san16132/Actuadores-Lineales/README.md

# Actuadores-Lineales

Diseños y código de actuadores lineales de faja, tornillo y cremallera.
