san16132/Actuadores-Lineales/Inventor Actuadores/BOM/BOM Cremallera.xlsx

Item | Nombre | Thumbnail | Precio | QTY | Total | Descripción | REV
1 | Acople eje motor |  | Q 10.00 | 1 | Q 10.00 | Impresión 3D | IR
2 | Engrane |  | Q 5.00 | 1 | Q 5.00 | Corte Láser | IR
3 | Cremallera |  | Q 5.00 | 1 | Q 5.00 | Corte Láser | IR
4 | Riel cremallera p1 |  | Q 5.00 | 1 | Q 5.00 | Corte Láser | IR
5 | Riel cremallera p2 |  | Q 5.00 | 1 | Q 5.00 | Corte Láser | IR
6 | Nema_17-17HS4401 |  | Q 100.00 | 1 | Q 80.00 | https://www.amazon.com/Usongshine-Stepper-17HS4401S-Connector-Printer/dp/B0787BQ4WH | IR
7 | Tope riel motor |  | Q 5.00 | 1 | Q 5.00 | Corte Láser | IR
8 | Riel acople de motor |  | Q 15.00 | 1 | Q 15.00 | Impresión 3D | IR
9 | M3.5 |  | Q 9.00 | 4 | Q 36.00 | La Casa del Tornillo | IR
10 | M3 |  | Q 8.00 | 1 | Q 8.00 | La Casa del Tornillo | IR
11 | Push Button |  | Q 1.00 | 2 | Q 2.00 | Electrónica ABC | IR
