san16132/Actuadores-Lineales/Inventor Actuadores/BOM/BOM Faja.xlsx

Item | Nombre | Imagen | Precio | QTY | Total | Descripción | REV
1 | Nema_17-17HS4401 |  | Q 100.00 | 1 | Q 100.00 | https://www.amazon.com/Usongshine-Stepper-17HS4401S-Connector-Printer/dp/B0787BQ4WH | IR
2 | Acople eje motor |  | Q 10.00 | 1 | Q 10.00 | Impresión 3D | IR
3 | Faja motor |  | Q 10.00 | 2 | Q 20.00 | Impresión 3D | IR
4 | Riel |  | Q 8.00 | 2 | Q 16.00 | Librería Progreso | IR
5 | Salida |  | Q 10.00 | 1 | Q 10.00 | Impresión 3D | IR
6 | Tope riel final |  | Q 5.00 | 2 | Q 10.00 | Corte Láser | IR
7 | Tope riel motor 2 |  | Q 5.00 | 1 | Q 5.00 | Corte Láser | IR
8 | Anillo riel |  | Q 5.00 | 2 | Q 10.00 | Corte Láser | IR
9 | Tope riel motor |  | Q 5.00 | 1 | Q 5.00 | Corte Láser | IR
10 | Eje |  | Q 8.00 | 1 | Q 8.00 | Librería Progreso | IR
11 | Eje 2 |  | Q 2.00 | 1 | Q 2.00 | Librería Progreso | IR
12 | M3.5 |  | Q 9.00 | 4 | Q 36.00 | La Casa del Tornillo | IR
13 | M3 |  | Q 7.00 | 1 | Q 7.00 | La Casa del Tornillo | IR
14 | faja |  | Q 10.00 | 1 | Q 10.00 | - | IR
15 | Pin |  | Q 2.00 | 2 | Q 4.00 | Librería Progreso | IR
16 | Push Button |  | Q 1.00 | 2 | Q 2.00 | Electrónica ABC | IR
