san16132/Actuadores-Lineales/Inventor Actuadores/BOM/BOM Tornillo.xlsx

Item | Nombre | Imagen | Precio | QTY | Total | Descripción | REV
1 | Nema_17-17HS4401 |  | Q 100.00 | 1 | Q 100.00 | https://www.amazon.com/Usongshine-Stepper-17HS4401S-Connector-Printer/dp/B0787BQ4WH | IR
2 | Acople eje motor |  | Q 10.00 | 1 | Q 10.00 | Impresión 3D | IR
3 | Acople tornillo M8 |  | Q 10.00 | 1 | Q 10.00 | Impresión 3D | IR
4 | Tope riel motor |  | Q 5.00 | 1 | Q 5.00 | Corte Láser | IR
5 | Tope riel final |  | Q 5.00 | 1 | Q 5.00 | Corte Láser | IR
6 | Riel |  | Q 8.00 | 2 | Q 16.00 | Librería Progreso | IR
7 | Anillo riel |  | Q 5.00 | 2 | Q 10.00 | Corte Láser | IR
8 | Acople tuerca salida |  | Q 10.00 | 1 | Q 10.00 | Impresión 3D | IR
9 | Base |  | Q 5.00 | 1 | Q 5.00 | Corte Láser | IR
10 | M3.5 |  | Q 9.00 | 4 | Q 36.00 | La Casa del Tornillo | IR
11 | M3 |  | Q 7.00 | 1 | Q 7.00 | La Casa del Tormillo | IR
12 | Tornillo |  | Q 10.00 | 1 | Q 10.00 | Cemaco | IR
13 | Tuerca |  | Q 1.00 | 1 | Q 1.00 | Cemaco | IR
14 | Push Button |  | Q 1.00 | 2 | Q 2.00 | Electrónica ABC | IR
