san16132/Actuadores-Lineales/Inventor Actuadores/Actuador Cremallera/Fabricación/Riel acople de motor.stl

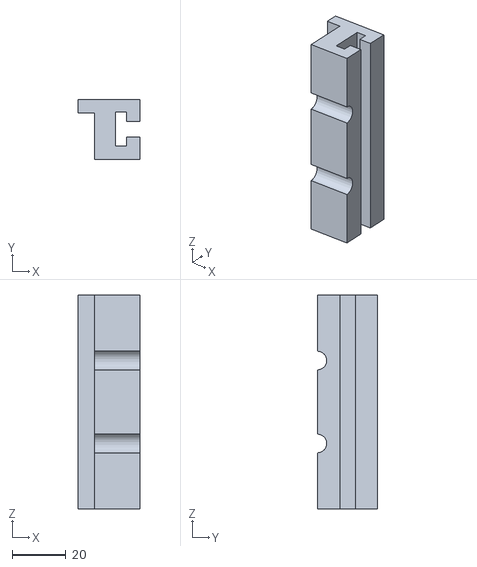
[picture p3: CAD file, 2020-03-03]
Inventor Actuadores/Actuador Cremallera/Fabricación/Riel acople de motor.stl
23.0 x 22.5 x 80.0
