san16132/Actuadores-Lineales/Inventor Actuadores/Actuador Faja/Fabricación/Faja motor largo.stl

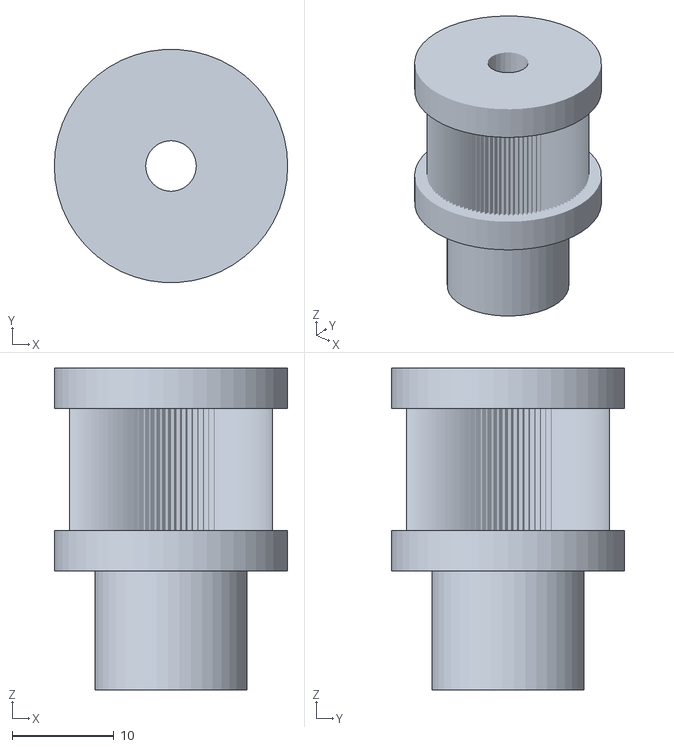
[picture p4: CAD file, 2020-03-03]
Inventor Actuadores/Actuador Faja/Fabricación/Faja motor largo.stl
23.0 x 23.0 x 31.7
