san16132/Actuadores-Lineales/Inventor Actuadores/Actuador Tornillo/Fabricación/Acople tuerca salida.stl

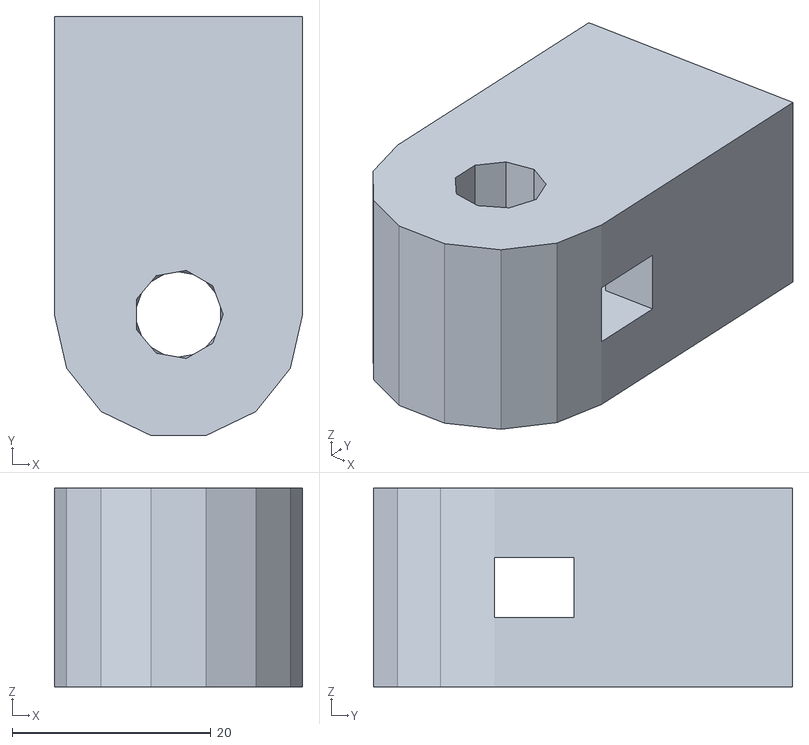
[picture p5: CAD file, 2020-03-03]
Inventor Actuadores/Actuador Tornillo/Fabricación/Acople tuerca salida.stl
25.0 x 42.2 x 20.0
