san16132/Actuadores-Lineales/Inventor Actuadores/Actuador Tornillo/Nema 17/Nema_17-17HS4401.step

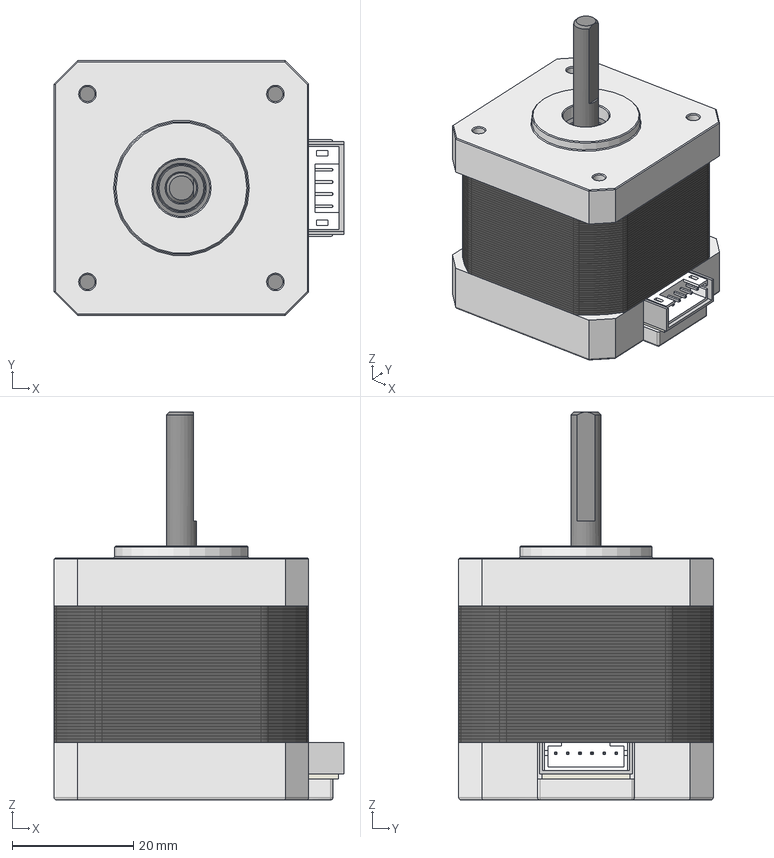
[picture p6: CAD file, 2020-03-03]
Inventor Actuadores/Actuador Tornillo/Nema 17/Nema_17-17HS4401.step
47.8 x 42.0 x 64.0 mm
M3x30-Screw_001
M3x30-Screw_002
M3x30-Screw_003
M3x30-Screw_004
