san16132/Actuadores-Lineales/Inventor Actuadores/Fabricación/Actualizados/Impresión 3D/Faja motor largo.stl

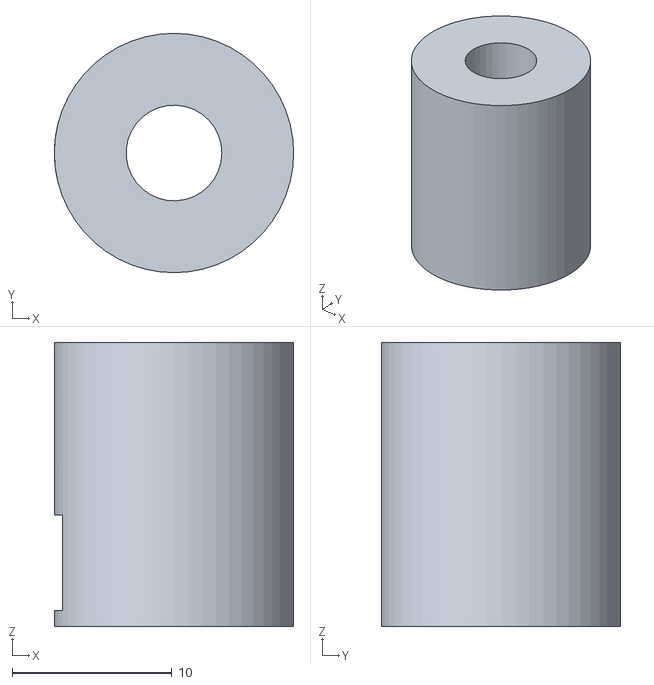
[picture p7: CAD file, 2020-03-03]
Inventor Actuadores/Fabricación/Actualizados/Impresión 3D/Faja motor largo.stl
15.0 x 15.0 x 17.8
