san16132/Actuadores-Lineales/Inventor Actuadores/Actuador Faja/Fabricación/Acople eje motor.stl

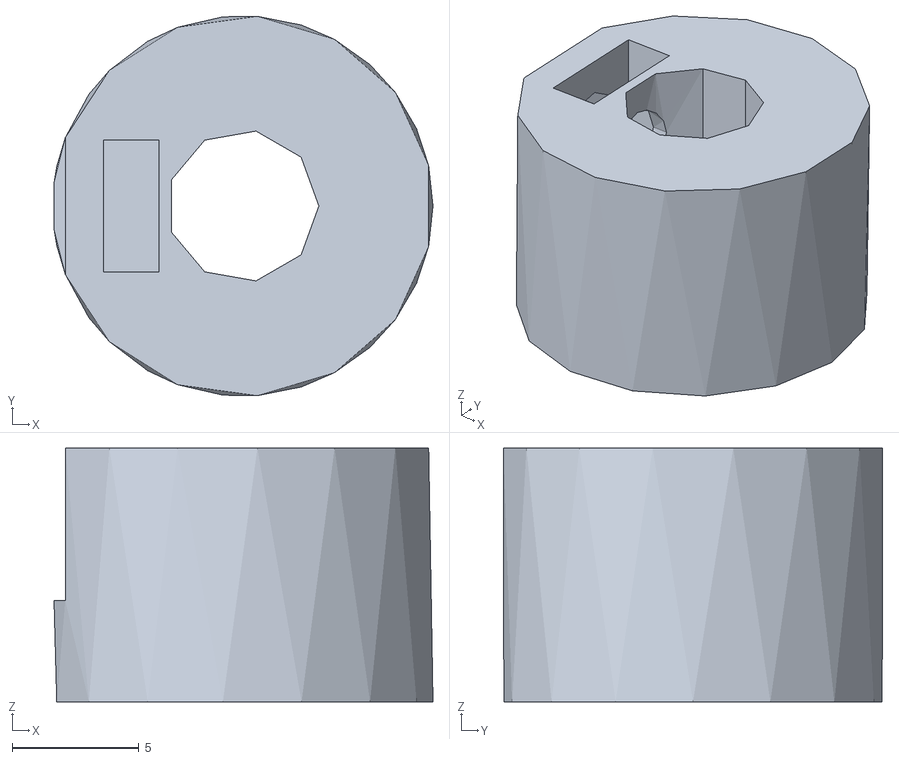
[picture p8: CAD file, 2020-03-03]
Inventor Actuadores/Actuador Faja/Fabricación/Acople eje motor.stl
14.9 x 15.0 x 10.0
