san16132/Actuadores-Lineales/Inventor Actuadores/Actuador Tornillo/Fabricación/Acople tornillo M8.stl

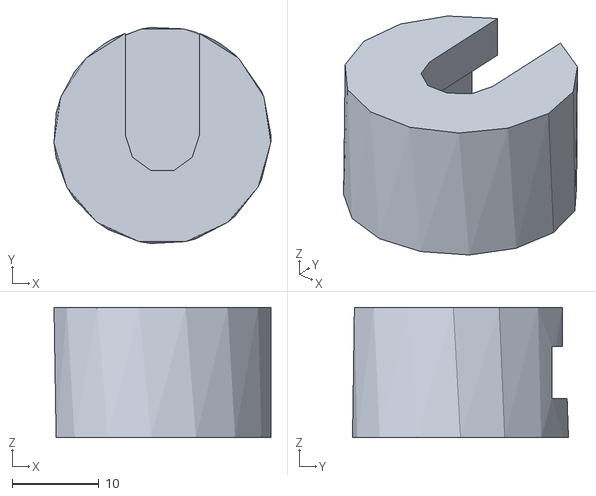
[picture p9: CAD file, 2020-03-03]
Inventor Actuadores/Actuador Tornillo/Fabricación/Acople tornillo M8.stl
25.0 x 24.9 x 15.0
