san16132/Actuadores-Lineales/Inventor Actuadores/Fabricación/Actualizados/Impresión 3D/Acople tornillo 1_4.stl

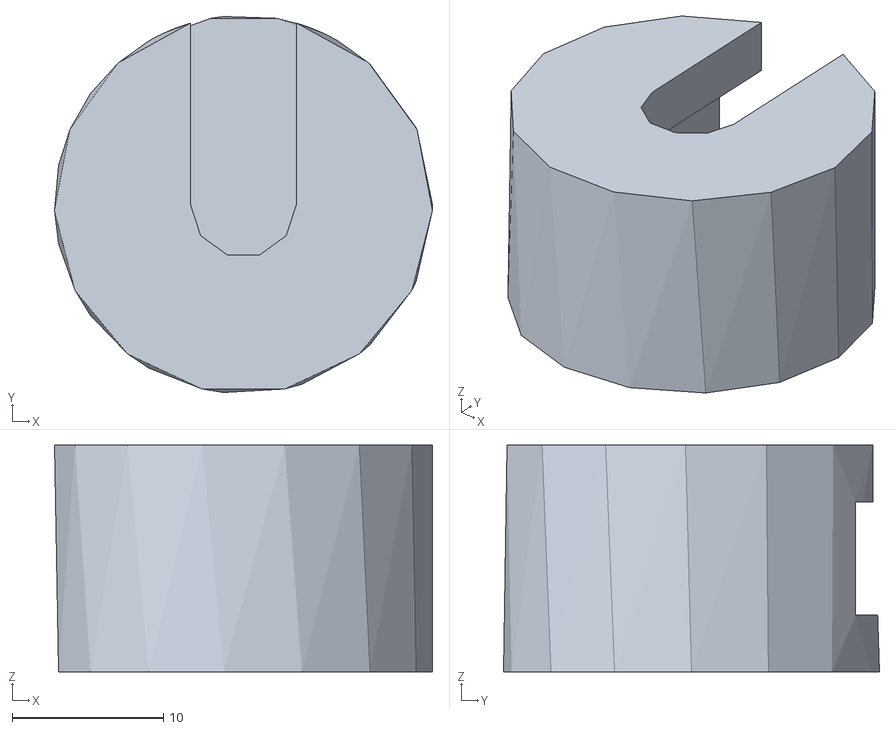
[picture p10: CAD file, 2020-03-03]
Inventor Actuadores/Fabricación/Actualizados/Impresión 3D/Acople tornillo 1_4.stl
25.0 x 24.9 x 15.0
