san16132/Actuadores-Lineales/Inventor Actuadores/Fabricación/Impresiones 3D/Faja motor largo.stl

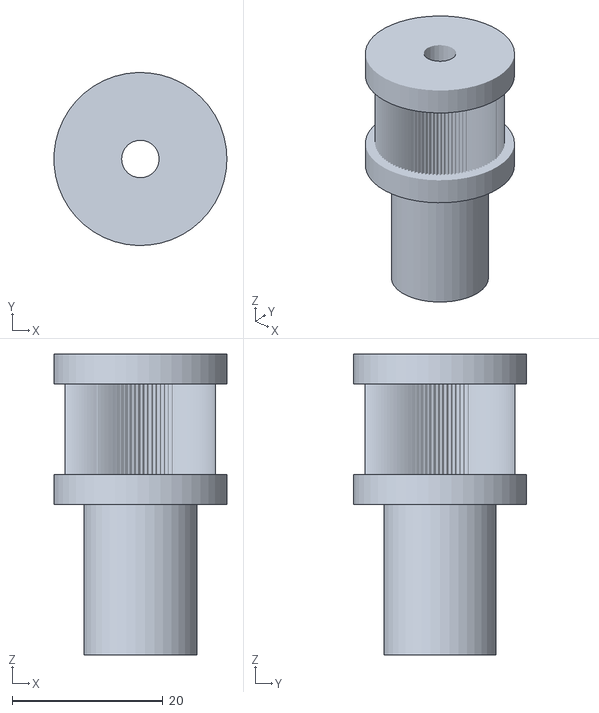
[picture p11: CAD file, 2020-03-03]
Inventor Actuadores/Fabricación/Impresiones 3D/Faja motor largo.stl
23.0 x 23.0 x 40.0
