san16132/Actuadores-Lineales/Inventor Actuadores/Actuador Faja/Fabricación/Salida.stl

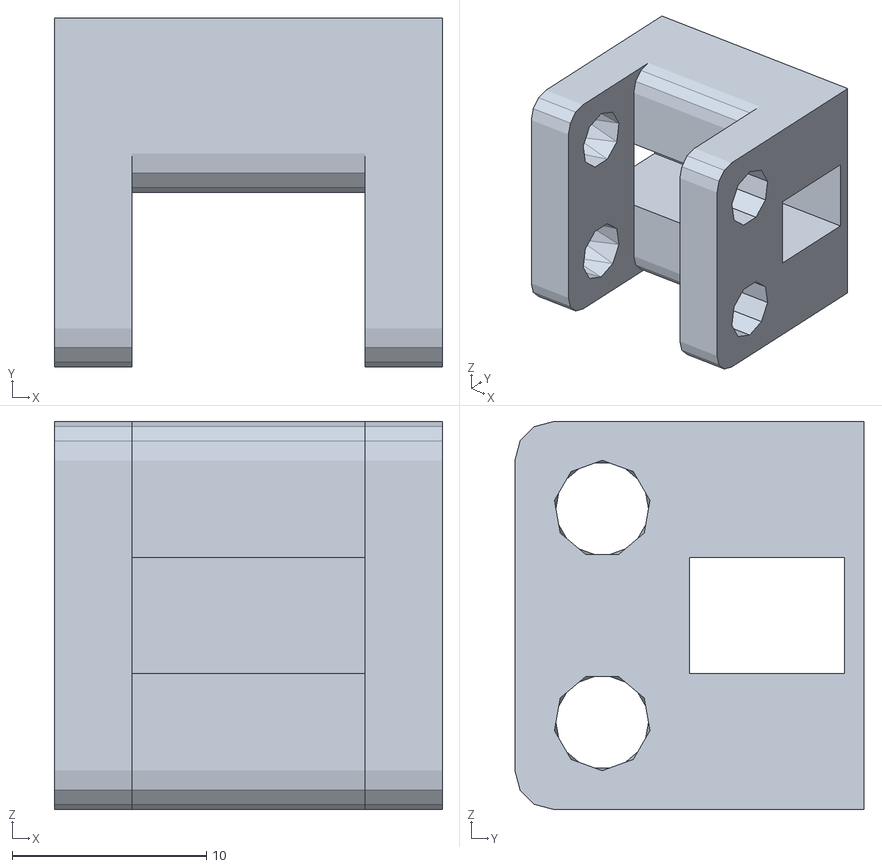
[picture p12: CAD file, 2020-03-03]
Inventor Actuadores/Actuador Faja/Fabricación/Salida.stl
20.0 x 18.0 x 20.0
