san16132/Actuadores-Lineales/Inventor Actuadores/Fabricación/Actualizados/Impresión 3D/Acople tuerca salida.stl

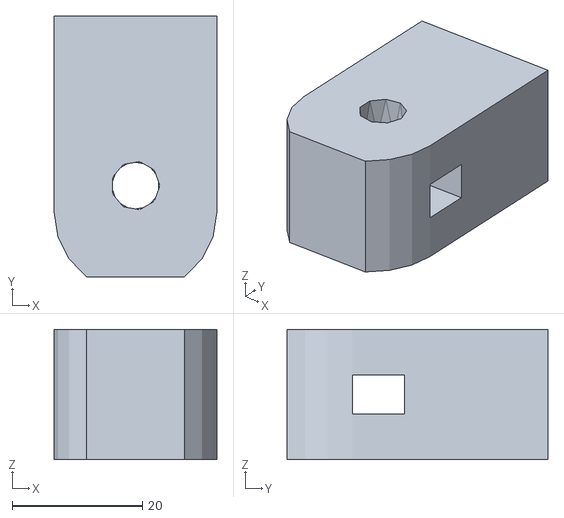
[picture p13: CAD file, 2020-03-03]
Inventor Actuadores/Fabricación/Actualizados/Impresión 3D/Acople tuerca salida.stl
25.0 x 40.0 x 20.0
