san16132/Actuadores-Lineales/Inventor Actuadores/Actuador Faja/Fabricación/Faja motor.stl

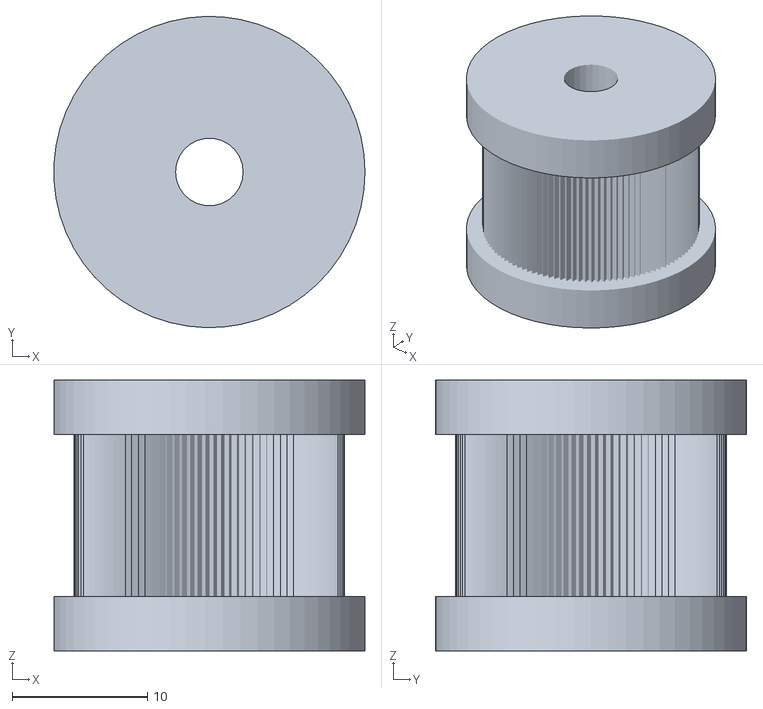
[picture p14: CAD file, 2020-03-03]
Inventor Actuadores/Actuador Faja/Fabricación/Faja motor.stl
23.0 x 23.0 x 20.0
