san16132/Actuadores-Lineales/Inventor Actuadores/Fabricación/Actualizados/Impresión 3D/Salida faja.stl

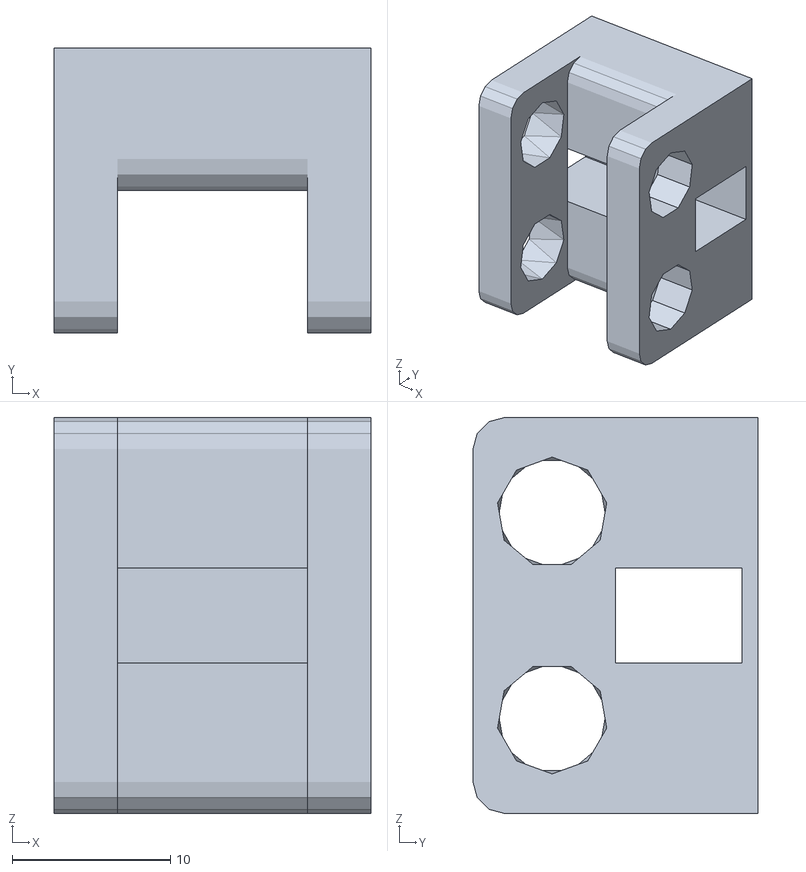
[picture p15: CAD file, 2020-03-03]
Inventor Actuadores/Fabricación/Actualizados/Impresión 3D/Salida faja.stl
20.0 x 18.0 x 25.0
