san16132/Actuadores-Lineales/Inventor Actuadores/Fabricación/Actualizados/Impresión 3D/Faja motor.stl

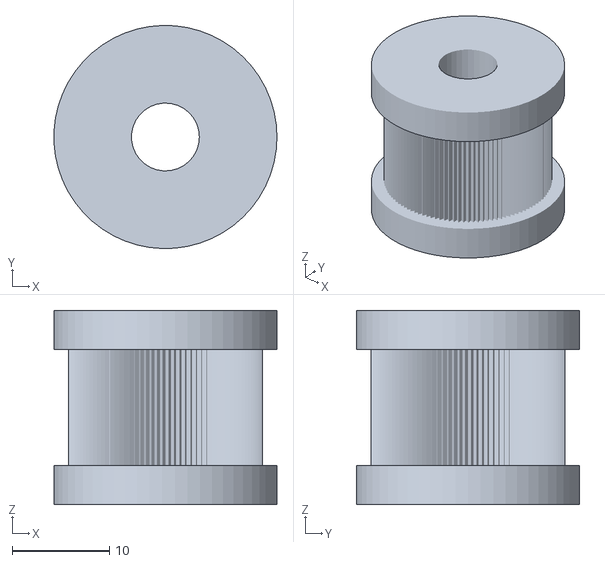
[picture p16: CAD file, 2020-03-03]
Inventor Actuadores/Fabricación/Actualizados/Impresión 3D/Faja motor.stl
23.0 x 23.0 x 20.0
