san16132/Actuadores-Lineales/(list of files, cad)

Other CAD files:
Inventor Actuadores/Fabricación/Impresiones 3D/Acople eje motor largo.stl
Inventor Actuadores/Actuador Tornillo/Fabricación/Acople eje motor.stl
Inventor Actuadores/Fabricación/Impresiones 3D/Acople tuerca salida nivel.stl
Inventor Actuadores/Actuador Cremallera/Acople eje motor.ipt
Inventor Actuadores/Actuador Cremallera/Actuador Cremallera.iam
Inventor Actuadores/Actuador Cremallera/Actuador Cremallera.ipn
Inventor Actuadores/Actuador Cremallera/Cremallera.ipt
Inventor Actuadores/Actuador Cremallera/Engrane.iam
Inventor Actuadores/Actuador Cremallera/Engrane/Design Accelerator/OldVersions/Spur Gear11.0004.ipt
Inventor Actuadores/Actuador Cremallera/Engrane/Design Accelerator/OldVersions/Spur Gears1.0001.iam
Inventor Actuadores/Actuador Cremallera/Engrane/Design Accelerator/Spur Gear11.ipt
Inventor Actuadores/Actuador Cremallera/Engrane/Design Accelerator/Spur Gears1.iam
Inventor Actuadores/Actuador Cremallera/Fabricación/3 mm.idw
Inventor Actuadores/Actuador Cremallera/Fabricación/6 mm.idw
Inventor Actuadores/Actuador Cremallera/M3.5.ipt
Inventor Actuadores/Actuador Cremallera/M3.ipt
Inventor Actuadores/Actuador Cremallera/Nema 17/OldVersions/Nema_17-17HS4401.0003.iam
Inventor Actuadores/Actuador Cremallera/OldVersions/Acople eje motor.0006.ipt
Inventor Actuadores/Actuador Cremallera/OldVersions/Actuador Cremallera.0001.ipn
Inventor Actuadores/Actuador Cremallera/OldVersions/Actuador Cremallera.0012.iam
Inventor Actuadores/Actuador Cremallera/OldVersions/Cremallera.0002.ipt
Inventor Actuadores/Actuador Cremallera/OldVersions/Engrane.0002.iam
Inventor Actuadores/Actuador Cremallera/OldVersions/Riel acople de motor.0001.ipt
Inventor Actuadores/Actuador Cremallera/OldVersions/Riel acople de motor.0006.ipt
Inventor Actuadores/Actuador Cremallera/OldVersions/Riel acople de motor.0013.ipt
Inventor Actuadores/Actuador Cremallera/OldVersions/Riel cremallera p1.0001.ipt
Inventor Actuadores/Actuador Cremallera/OldVersions/Riel cremallera p2.0002.ipt
Inventor Actuadores/Actuador Cremallera/OldVersions/Tope riel motor.0006.ipt
Inventor Actuadores/Actuador Cremallera/Riel acople de motor.ipt
Inventor Actuadores/Actuador Cremallera/Riel cremallera p1.ipt
Inventor Actuadores/Actuador Cremallera/Riel cremallera p2.ipt
Inventor Actuadores/Actuador Cremallera/Tope riel motor.ipt
Inventor Actuadores/Actuador Faja/Acople eje motor.ipt
Inventor Actuadores/Actuador Faja/Anillo riel.ipt
Inventor Actuadores/Actuador Faja/Eje 2.ipt
Inventor Actuadores/Actuador Faja/Eje.ipt
Inventor Actuadores/Actuador Faja/Ensamble actuador faja.iam
Inventor Actuadores/Actuador Faja/Ensamble actuador faja.ipn
Inventor Actuadores/Actuador Faja/Fabricación/6 mm.idw
Inventor Actuadores/Actuador Faja/Fabricación/OldVersions/3 mm.0001.idw
Inventor Actuadores/Actuador Faja/Fabricación/OldVersions/6 mm.0003.idw
Inventor Actuadores/Actuador Faja/Faja motor largo.ipt
Inventor Actuadores/Actuador Faja/Faja motor.ipt
Inventor Actuadores/Actuador Faja/M3.5.ipt
Inventor Actuadores/Actuador Faja/M3.ipt
Inventor Actuadores/Actuador Faja/OldVersions/Acople eje motor.0005.ipt
Inventor Actuadores/Actuador Faja/OldVersions/Acople eje motor.0006.ipt
Inventor Actuadores/Actuador Faja/OldVersions/Anillo riel.0007.ipt
Inventor Actuadores/Actuador Faja/OldVersions/Eje 2.0002.ipt
Inventor Actuadores/Actuador Faja/OldVersions/Eje.0002.ipt
Inventor Actuadores/Actuador Faja/OldVersions/Ensamble actuador faja.0011.iam
Inventor Actuadores/Actuador Faja/OldVersions/Faja motor largo.0007.ipt
Inventor Actuadores/Actuador Faja/OldVersions/Faja motor.0004.ipt
Inventor Actuadores/Actuador Faja/OldVersions/Pin.0001.ipt
Inventor Actuadores/Actuador Faja/OldVersions/Riel.0003.ipt
Inventor Actuadores/Actuador Faja/OldVersions/Salida.0004.ipt
Inventor Actuadores/Actuador Faja/OldVersions/Tope riel final.0010.ipt
Inventor Actuadores/Actuador Faja/OldVersions/Tope riel motor 2.0004.ipt
Inventor Actuadores/Actuador Faja/OldVersions/Tope riel motor.0006.ipt
Inventor Actuadores/Actuador Faja/OldVersions/Tope riel motor.0008.ipt
Inventor Actuadores/Actuador Faja/OldVersions/faja.0001.ipt
Inventor Actuadores/Actuador Faja/Pin.ipt
Inventor Actuadores/Actuador Faja/Riel.ipt
Inventor Actuadores/Actuador Faja/Salida.ipt
Inventor Actuadores/Actuador Faja/Tope riel final.ipt
Inventor Actuadores/Actuador Faja/Tope riel motor 2.ipt
Inventor Actuadores/Actuador Faja/Tope riel motor.ipt
Inventor Actuadores/Actuador Faja/faja.ipt
Inventor Actuadores/Actuador Tornillo/Acople eje motor.ipt
Inventor Actuadores/Actuador Tornillo/Acople tornillo M8.ipt
Inventor Actuadores/Actuador Tornillo/Acople tuerca salida.ipt
Inventor Actuadores/Actuador Tornillo/Anillo riel.ipt
Inventor Actuadores/Actuador Tornillo/Base.ipt
Inventor Actuadores/Actuador Tornillo/Ensamble Actuador Tornillo.iam
Inventor Actuadores/Actuador Tornillo/Ensamble Actuador Tornillo.ipn
Inventor Actuadores/Actuador Tornillo/Fabricación/3 mm.idw
Inventor Actuadores/Actuador Tornillo/Fabricación/6 mm.idw
Inventor Actuadores/Actuador Tornillo/Fabricación/OldVersions/3 mm.0002.idw
Inventor Actuadores/Actuador Tornillo/Fabricación/OldVersions/6 mm.0003.idw
Inventor Actuadores/Actuador Tornillo/M3.5.ipt
Inventor Actuadores/Actuador Tornillo/M3.ipt
Inventor Actuadores/Actuador Tornillo/Nema 17/Axis&Rotor.ipt
Inventor Actuadores/Actuador Tornillo/Nema 17/BallBearing1.ipt
Inventor Actuadores/Actuador Tornillo/Nema 17/BallBearing2.ipt
Inventor Actuadores/Actuador Tornillo/Nema 17/Baseplate.ipt
Inventor Actuadores/Actuador Tornillo/Nema 17/ConnectorPins.iam
Inventor Actuadores/Actuador Tornillo/Nema 17/ConnectrorBody.ipt
Inventor Actuadores/Actuador Tornillo/Nema 17/Frontplate.ipt
Inventor Actuadores/Actuador Tornillo/Nema 17/Insulation.ipt
Inventor Actuadores/Actuador Tornillo/Nema 17/M3x30-Screw_001.ipt
Inventor Actuadores/Actuador Tornillo/Nema 17/M3x30-Screw_002.ipt
Inventor Actuadores/Actuador Tornillo/Nema 17/M3x30-Screw_003.ipt
Inventor Actuadores/Actuador Tornillo/Nema 17/M3x30-Screw_004.ipt
Inventor Actuadores/Actuador Tornillo/Nema 17/Nema_17-17HS4401.iam
Inventor Actuadores/Actuador Tornillo/Nema 17/OldVersions/ConnectorPins.0001.iam
Inventor Actuadores/Actuador Tornillo/Nema 17/OldVersions/Nema_17-17HS4401.0002.iam
Inventor Actuadores/Actuador Tornillo/Nema 17/OldVersions/Screws.0001.iam
Inventor Actuadores/Actuador Tornillo/Nema 17/PCB.ipt
Inventor Actuadores/Actuador Tornillo/Nema 17/SOLID.ipt
Inventor Actuadores/Actuador Tornillo/Nema 17/SOLID001.ipt
Inventor Actuadores/Actuador Tornillo/Nema 17/SOLID002.ipt
Inventor Actuadores/Actuador Tornillo/Nema 17/SOLID003.ipt
Inventor Actuadores/Actuador Tornillo/Nema 17/SOLID004.ipt
Inventor Actuadores/Actuador Tornillo/Nema 17/SOLID005.ipt
Inventor Actuadores/Actuador Tornillo/Nema 17/Screws.iam
Inventor Actuadores/Actuador Tornillo/Nema 17/Stator.ipt
Inventor Actuadores/Actuador Tornillo/OldVersions/Acople eje motor.0003.ipt
Inventor Actuadores/Actuador Tornillo/OldVersions/Acople tornillo M8.0003.ipt
Inventor Actuadores/Actuador Tornillo/OldVersions/Acople tuerca salida.0008.ipt
Inventor Actuadores/Actuador Tornillo/OldVersions/Anillo riel.0003.ipt
Inventor Actuadores/Actuador Tornillo/OldVersions/Base.0005.ipt
Inventor Actuadores/Actuador Tornillo/OldVersions/Ensamble Actuador Tornillo.0019.iam
Inventor Actuadores/Actuador Tornillo/OldVersions/M3.0001.ipt
Inventor Actuadores/Actuador Tornillo/OldVersions/M3.5.0001.ipt
Inventor Actuadores/Actuador Tornillo/OldVersions/Riel.0003.ipt
Inventor Actuadores/Actuador Tornillo/OldVersions/Tope riel final.0007.ipt
Inventor Actuadores/Actuador Tornillo/OldVersions/Tope riel motor.0003.ipt
Inventor Actuadores/Actuador Tornillo/OldVersions/Tope riel motor.0004.ipt
Inventor Actuadores/Actuador Tornillo/OldVersions/Tornillo M7.0002.ipt
Inventor Actuadores/Actuador Tornillo/OldVersions/Tornillo M7.0003.ipt
Inventor Actuadores/Actuador Tornillo/OldVersions/Tornillo.0001.ipt
Inventor Actuadores/Actuador Tornillo/OldVersions/Tuerca M7.0001.ipt
Inventor Actuadores/Actuador Tornillo/Riel.ipt
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
