san16132/Actuadores-Lineales/Inventor Actuadores/Actuador Tornillo/Fabricación/6mm.pdf

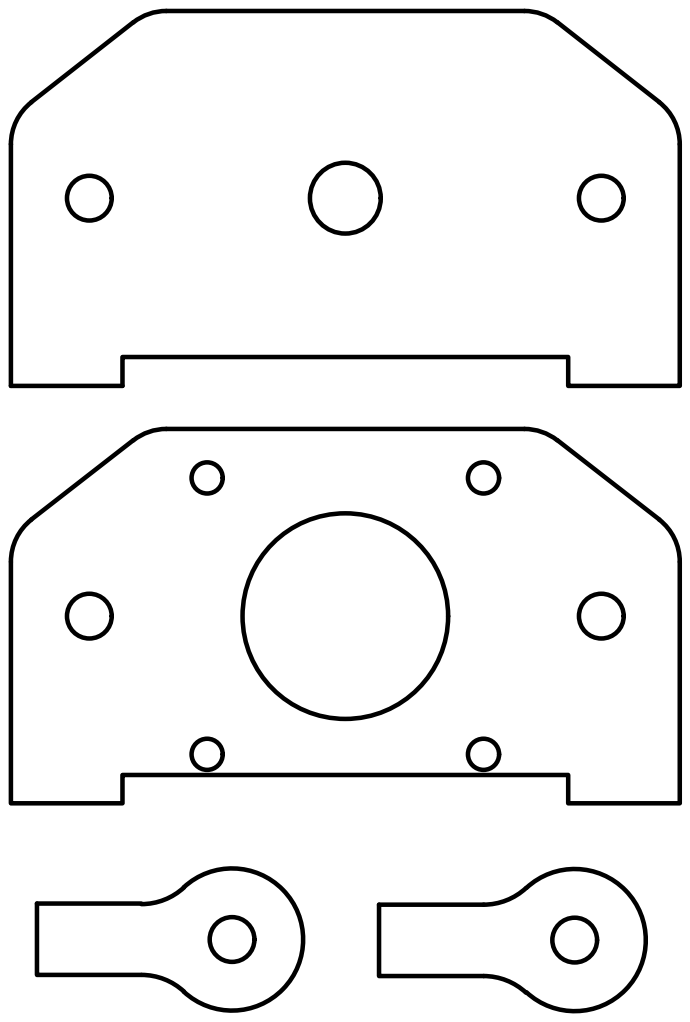
[picture p17: page 1]
