san16132/Actuadores-Lineales/Inventor Actuadores/Actuador Faja/Fabricación/6 mmf.pdf

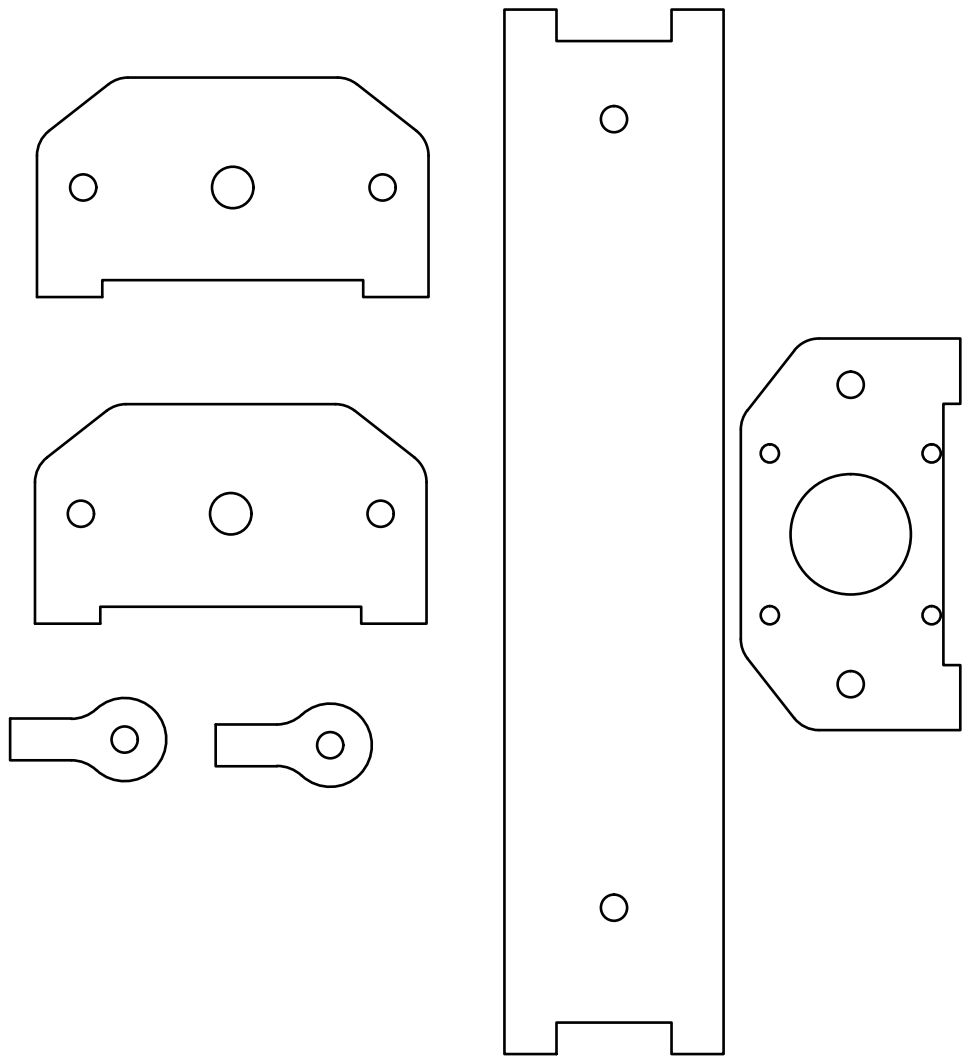
[picture p18: page 1]
