san16132/Actuadores-Lineales/Inventor Actuadores/Actuador Faja/Fabricación/faja.pdf

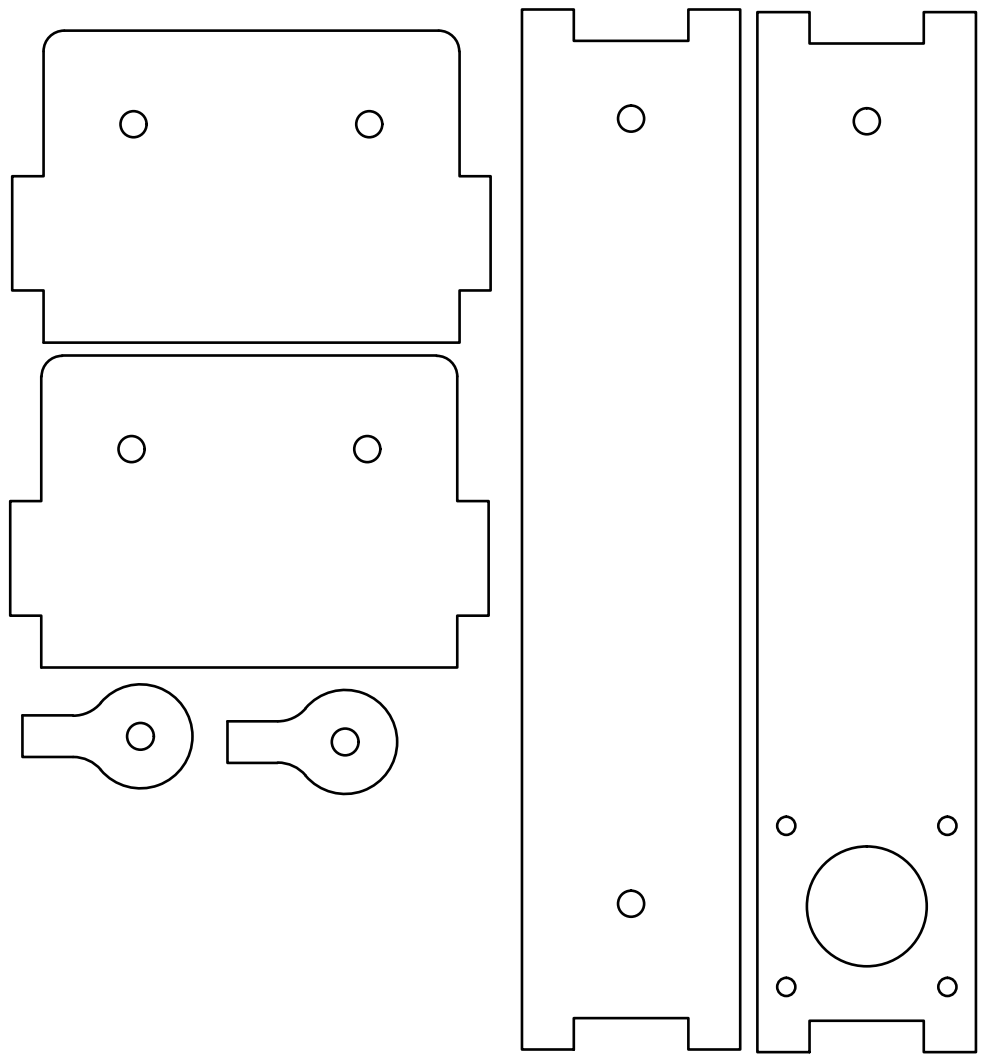
[picture p19: page 1]
