san16132/Actuadores-Lineales/Inventor Actuadores/Actuador Cremallera/Fabricación/6 mmc.pdf

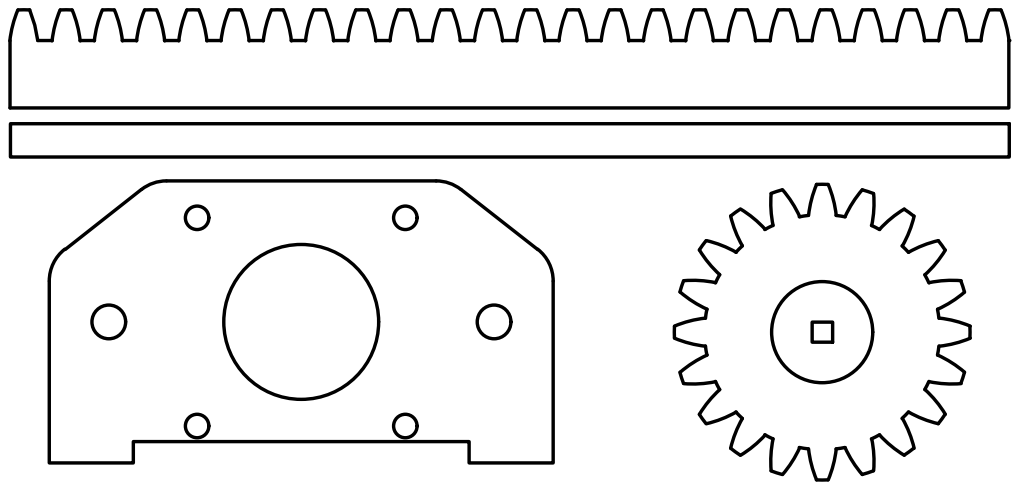
[picture p20: page 1]
