san16132/Actuadores-Lineales/Inventor Actuadores/Actuador Cremallera/Fabricación/Cremallera.pdf

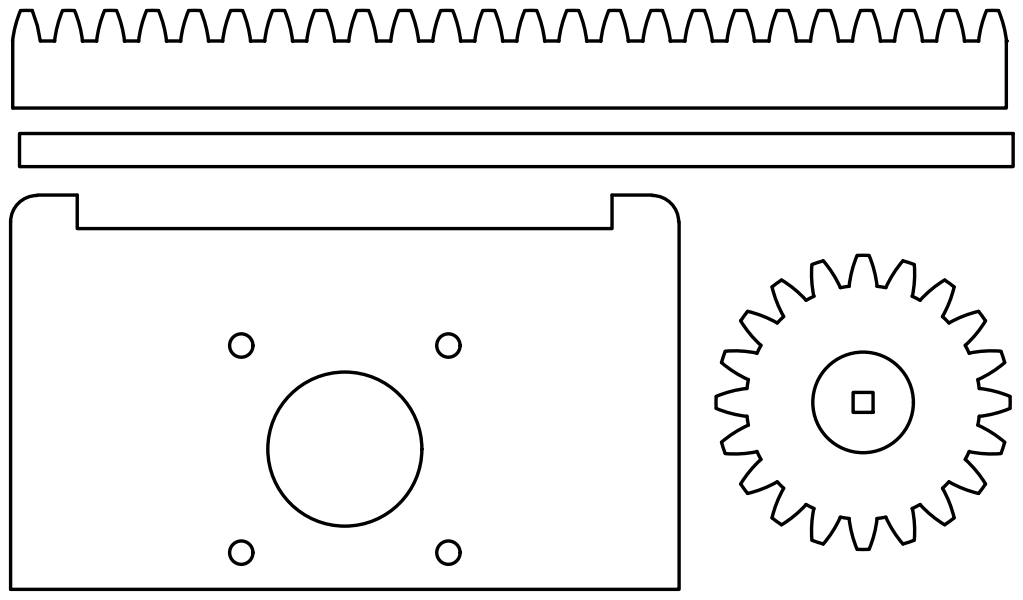
[picture p21: page 1]
