san16132/Actuadores-Lineales/Inventor Actuadores/Fabricación/Corte láser/6mm.pdf

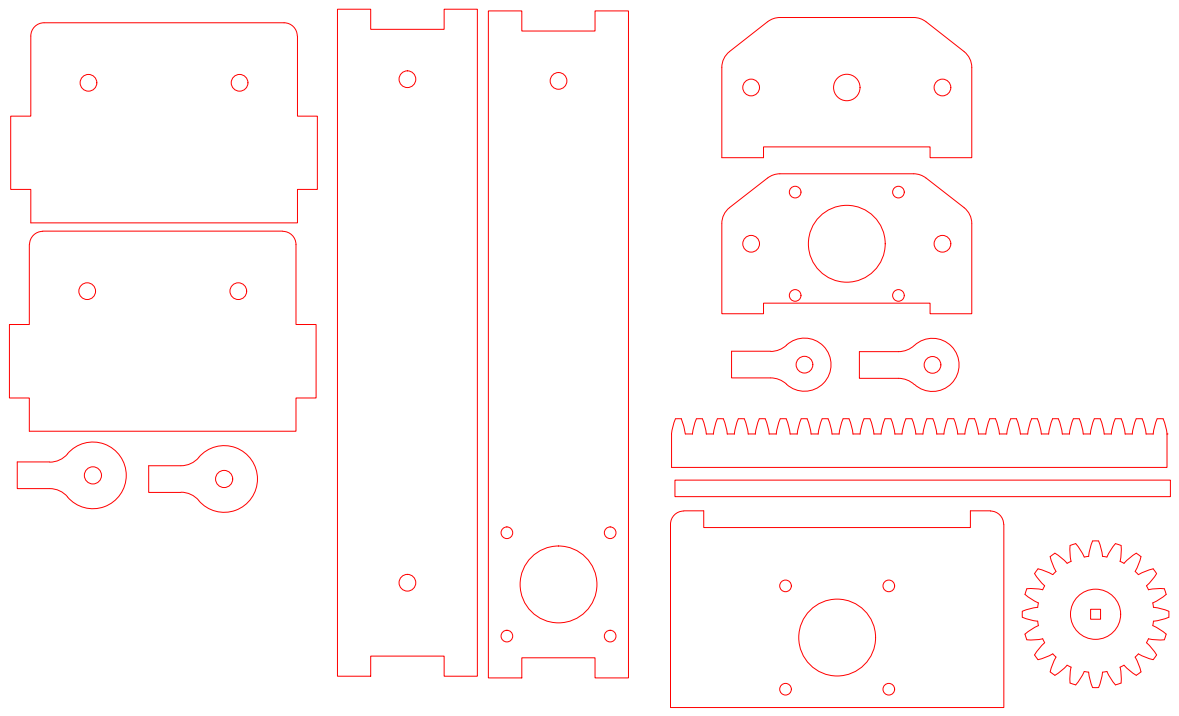
[picture p22: page 1]
