san16132/Actuadores-Lineales/Inventor Actuadores/Fabricación/Actualizados/Corte láser/6 mm faja.pdf

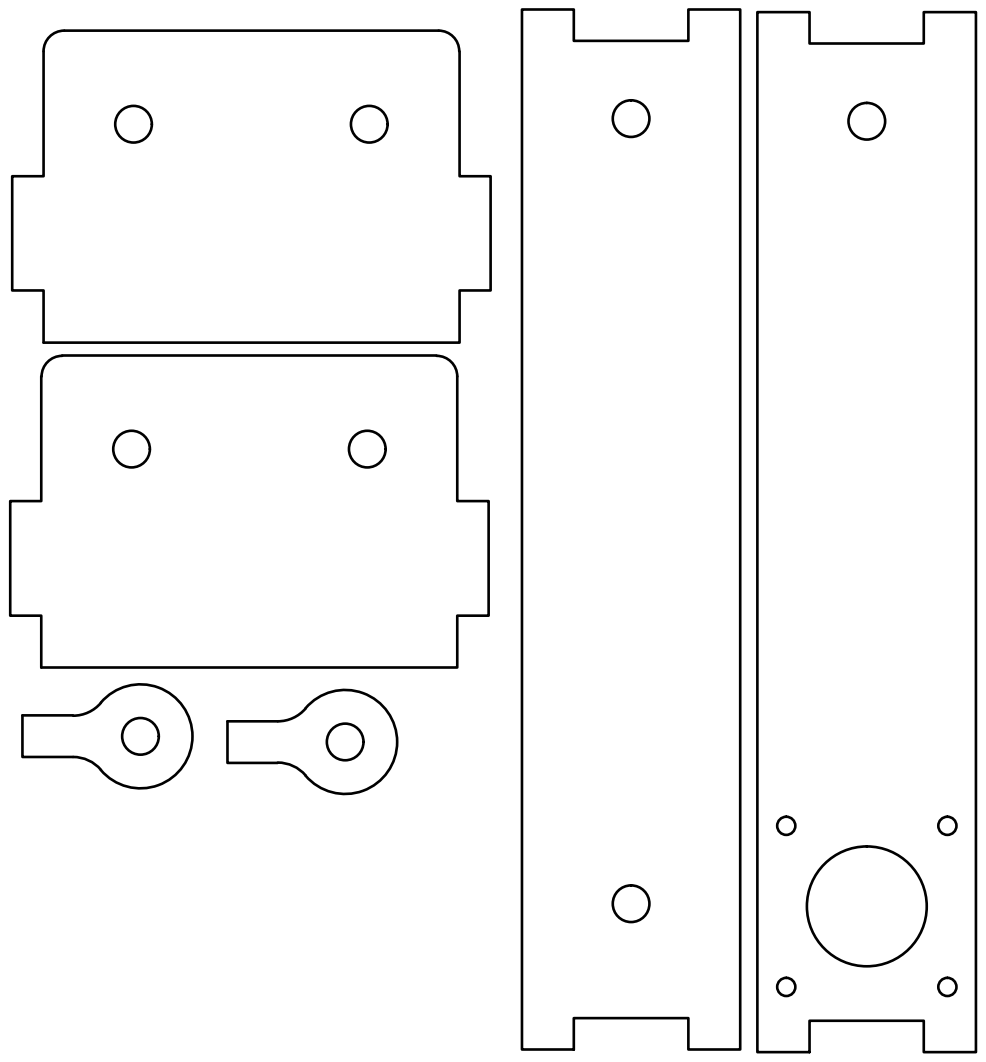
[picture p23: page 1]
