san16132/Actuadores-Lineales/Inventor Actuadores/Fabricación/Actualizados/Corte láser/6mm corte.pdf

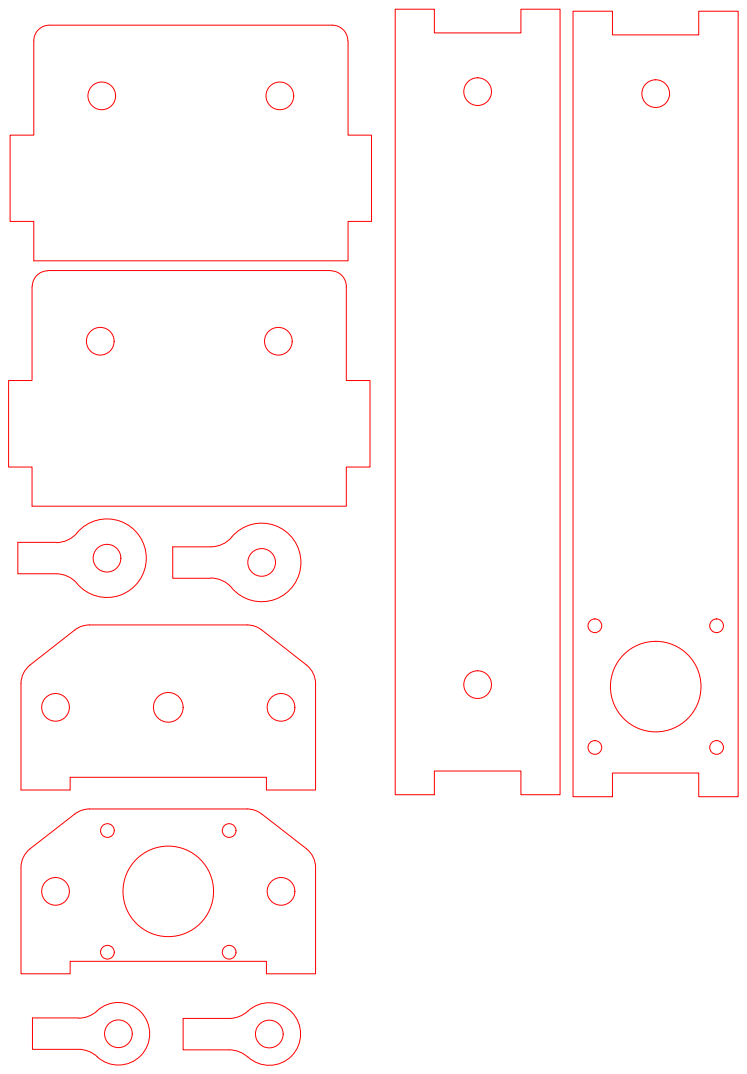
[picture p24: page 1]
