san16132/Actuadores-Lineales/Inventor Actuadores/Fabricación/Actualizados/Corte láser/6mm Tornillo.pdf

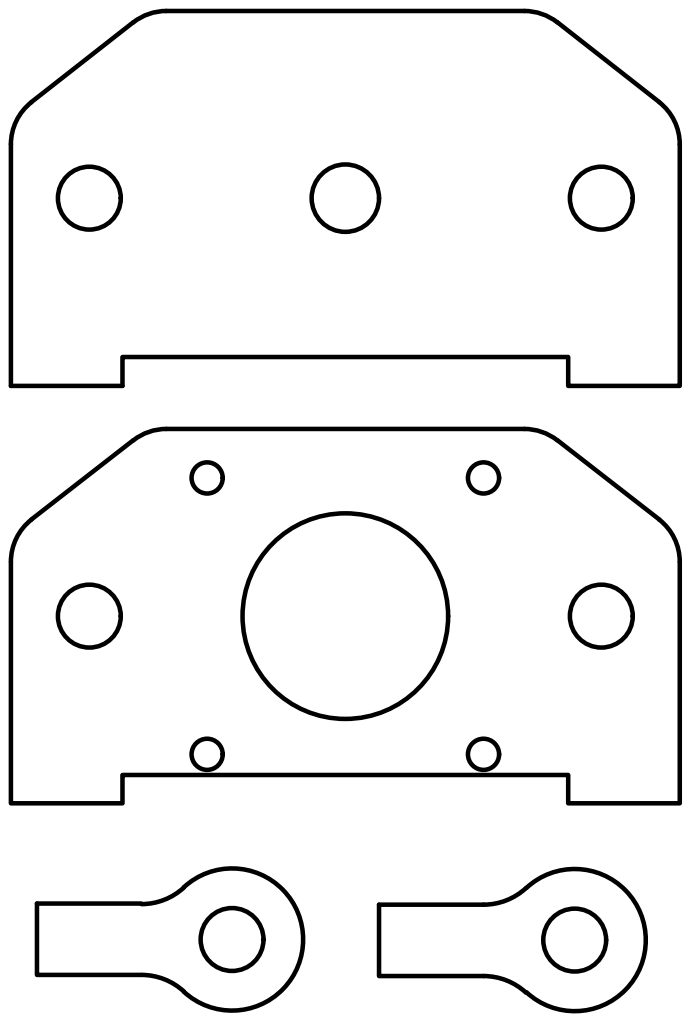
[picture p25: page 1]
